Board-Folk/PC-Engine/(threads)

Thread 3 (2023-12-18):

There are spaces for components that aren’t on my PC Engine - can I leave them unpopulated?

PJSOConnell, 2023-12-18:
Hi there - L103 and L105 don’t exist on my PC Engine board revision.
As a result I have gaps on my reproduction board - should I populate it with something else?

SteveMaddison, 2024-01-13:
Sorry, missed this over the holidays but hopefully you figured it out. Those inductors don't look critical and just go to ground. I suspect on your donor board there is just a direct connection, in which case you can just bridge those footprints.
