Board-Folk/PC-Engine/connectors.kicad_sch

## KiCad design connectors.kicad_sch (2023-11-15)

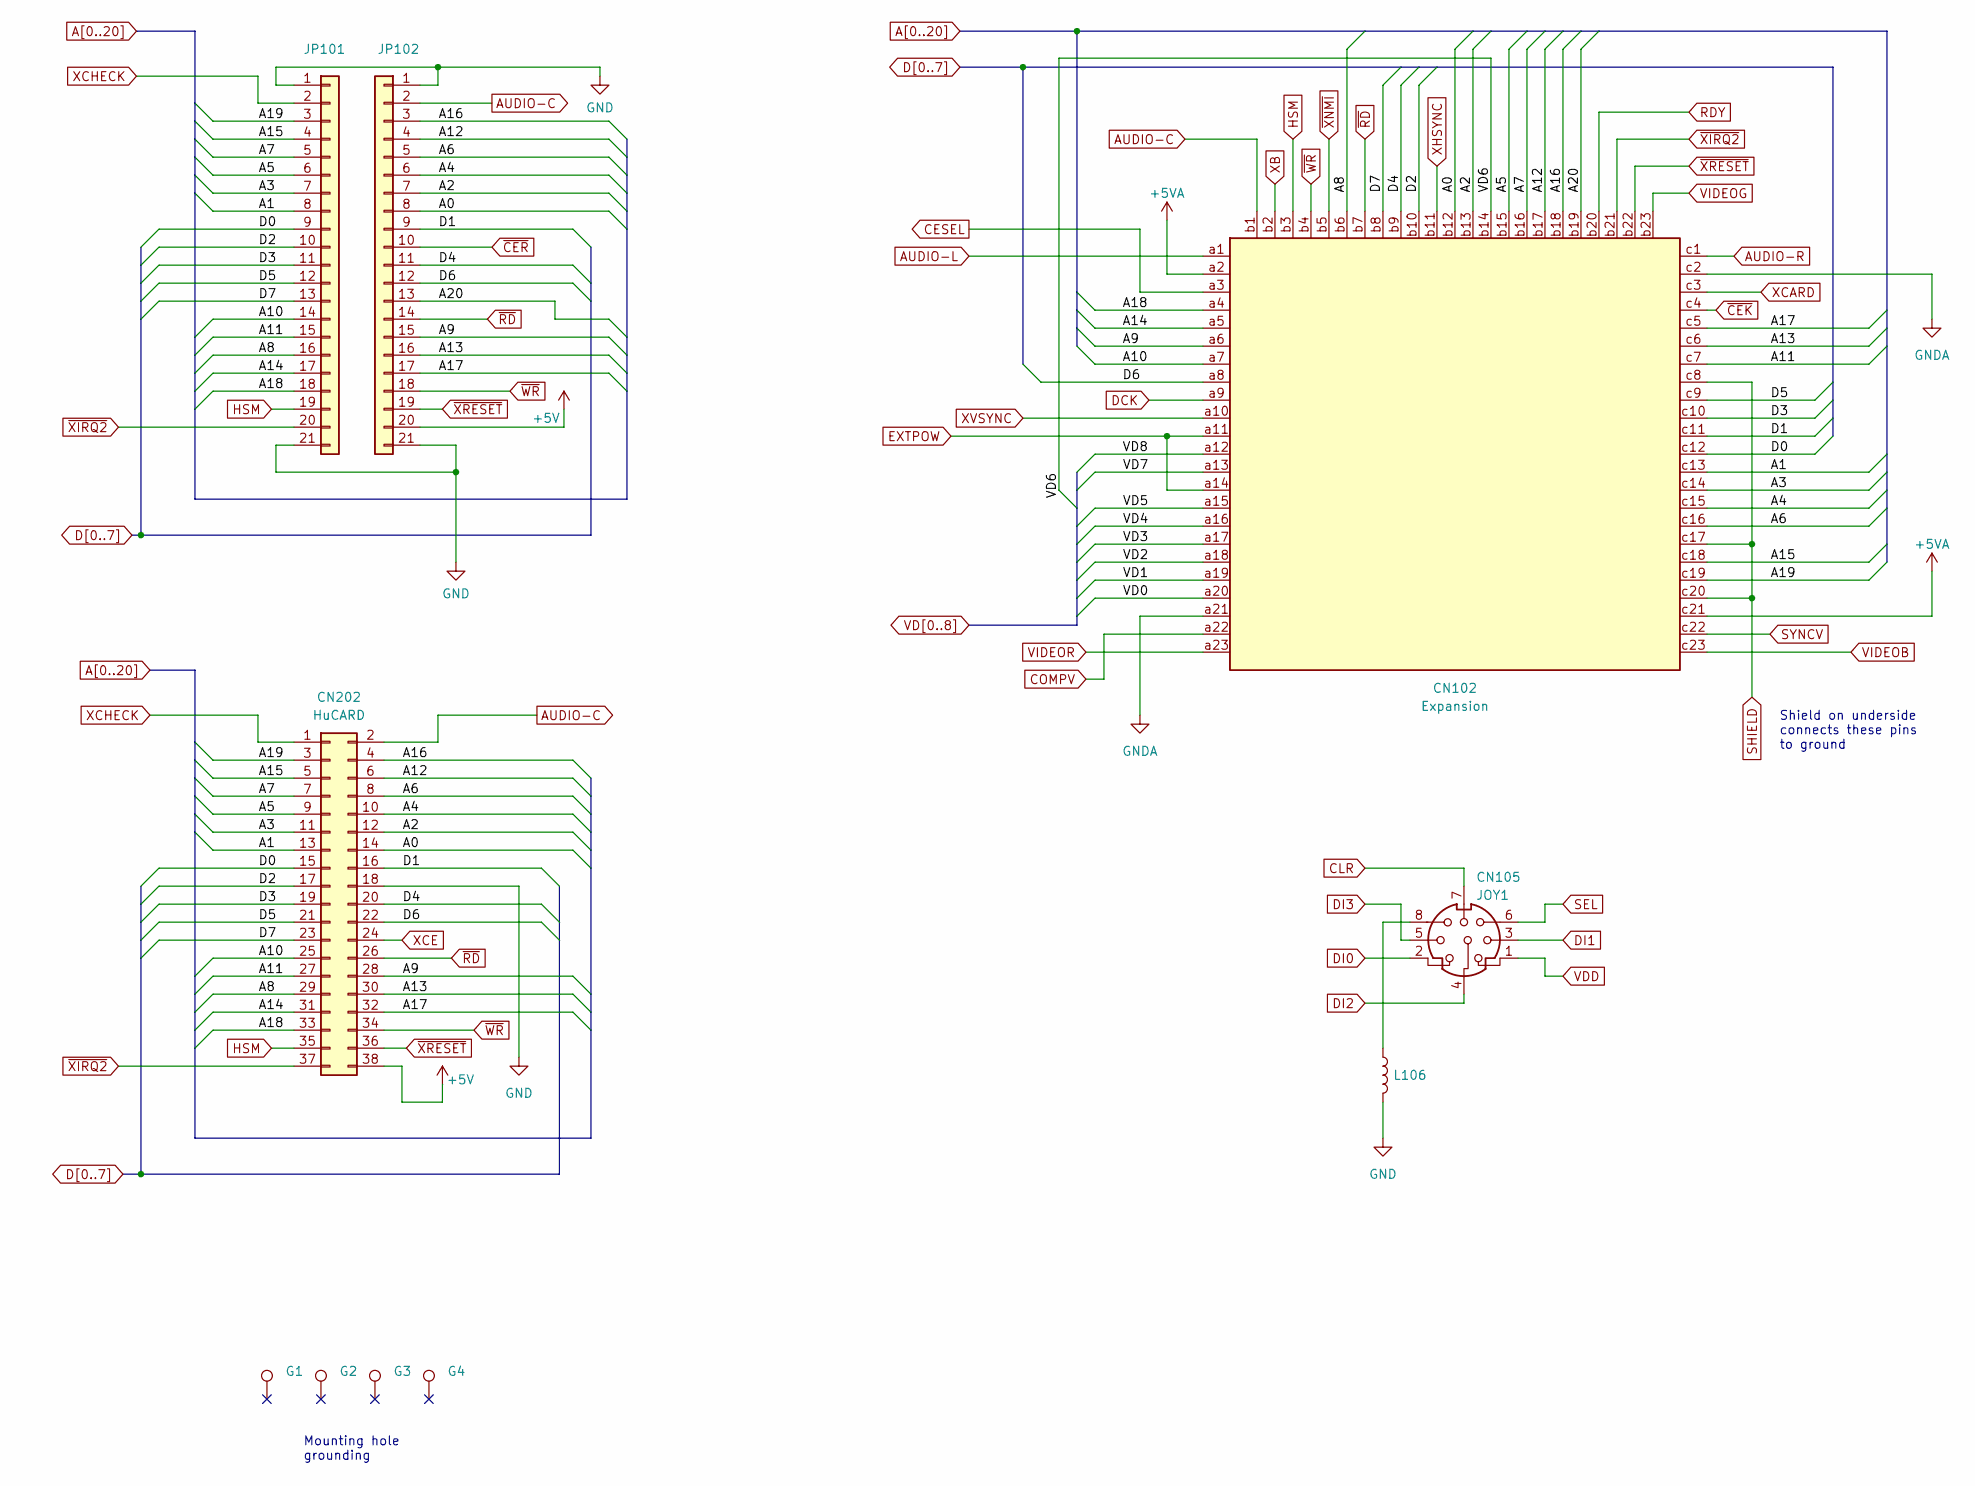
[picture p1: schematic connectors.kicad_sch]

Parts:
CN102: Expansion; CN102-2.54mm
CN105: JOY1; Mini-DIN-8
CN202: HuCARD
G1, G2, G3, G4: TestPoint; Grounding_pad
JP101, JP102: Conn_01x21; JP101-102-2.5mm
L106: L-5.00mm_Small_Silk

Connections:
+5V: CN202.38, JP102.20
+5VA: CN102.a2, CN102.c21
A0: CN102.b12, CN202.14, JP102.8
A1: CN102.c13, CN202.13, JP101.8
A2: CN102.b13, CN202.12, JP102.7
A3: CN102.c14, CN202.11, JP101.7
A4: CN102.c15, CN202.10, JP102.6
A5: CN102.b15, CN202.9, JP101.6
A6: CN102.c16, CN202.8, JP102.5
A7: CN102.b16, CN202.7, JP101.5
A8: CN102.b6, CN202.29, JP101.16
A9: CN102.a6, CN202.28, JP102.15
A10: CN102.a7, CN202.25, JP101.14
A11: CN102.c7, CN202.27, JP101.15
A12: CN102.b17, CN202.6, JP102.4
A13: CN102.c6, CN202.30, JP102.16
A14: CN102.a5, CN202.31, JP101.17
A15: CN102.c18, CN202.5, JP101.4
A16: CN102.b18, CN202.4, JP102.3
A17: CN102.c5, CN202.32, JP102.17
A18: CN102.a4, CN202.33, JP101.18
A19: CN102.c19, CN202.3, JP101.3
A20: CN102.b19, JP102.13
AUDIO-C: CN102.b1, CN202.2, JP102.2
AUDIO-L: CN102.a1
AUDIO-R: CN102.c1
CESEL: CN102.a3
CLR: CN105.7
COMPV: CN102.a22
D0: CN102.c12, CN202.15, JP101.9
D1: CN102.c11, CN202.16, JP102.9
D2: CN102.b10, CN202.17, JP101.10
D3: CN102.c10, CN202.19, JP101.11
D4: CN102.b9, CN202.20, JP102.11
D5: CN102.c9, CN202.21, JP101.12
D6: CN102.a8, CN202.22, JP102.12
D7: CN102.b8, CN202.23, JP101.13
DCK: CN102.a9
DI0: CN105.2
DI1: CN105.3
DI2: CN105.4
DI3: CN105.5
EXTPOW: CN102.a11, CN102.a14
GND: CN202.18, JP101.1, JP101.21, JP102.1, JP102.21, L106.2
GNDA: CN102.a21, CN102.c2
HSM: CN102.b3, CN202.35, JP101.19
unnamed: CN105.8, L106.1
RDY: CN102.b20
SEL: CN105.6
SHIELD: CN102.c8, CN102.c17, CN102.c20
SYNCV: CN102.c22
VD0: CN102.a20
VD1: CN102.a19
VD2: CN102.a18
VD3: CN102.a17
VD4: CN102.a16
VD5: CN102.a15
VD6: CN102.b14
VD7: CN102.a13
VD8: CN102.a12
VDD: CN105.1
VIDEOB: CN102.c23
VIDEOG: CN102.b23
VIDEOR: CN102.a23
XB: CN102.b2
XCARD: CN102.c3
XCE: CN202.24
XCHECK: CN202.1, JP101.2
XHSYNC: CN102.b11
XVSYNC: CN102.a10
~CEK: CN102.c4
~CER: JP102.10
~RD: CN102.b7, CN202.26, JP102.14
~WR: CN102.b4, CN202.34, JP102.18
~XIRQ2: CN102.b21, CN202.37, JP101.20
~XNMI: CN102.b5
~XRESET: CN102.b22, CN202.36, JP102.19

Notes on the sheet:
Shield on underside connects these pins to ground
Mounting hole grounding
