Board-Folk/PC-Engine/cpu.kicad_sch

## KiCad design cpu.kicad_sch (2023-11-15)

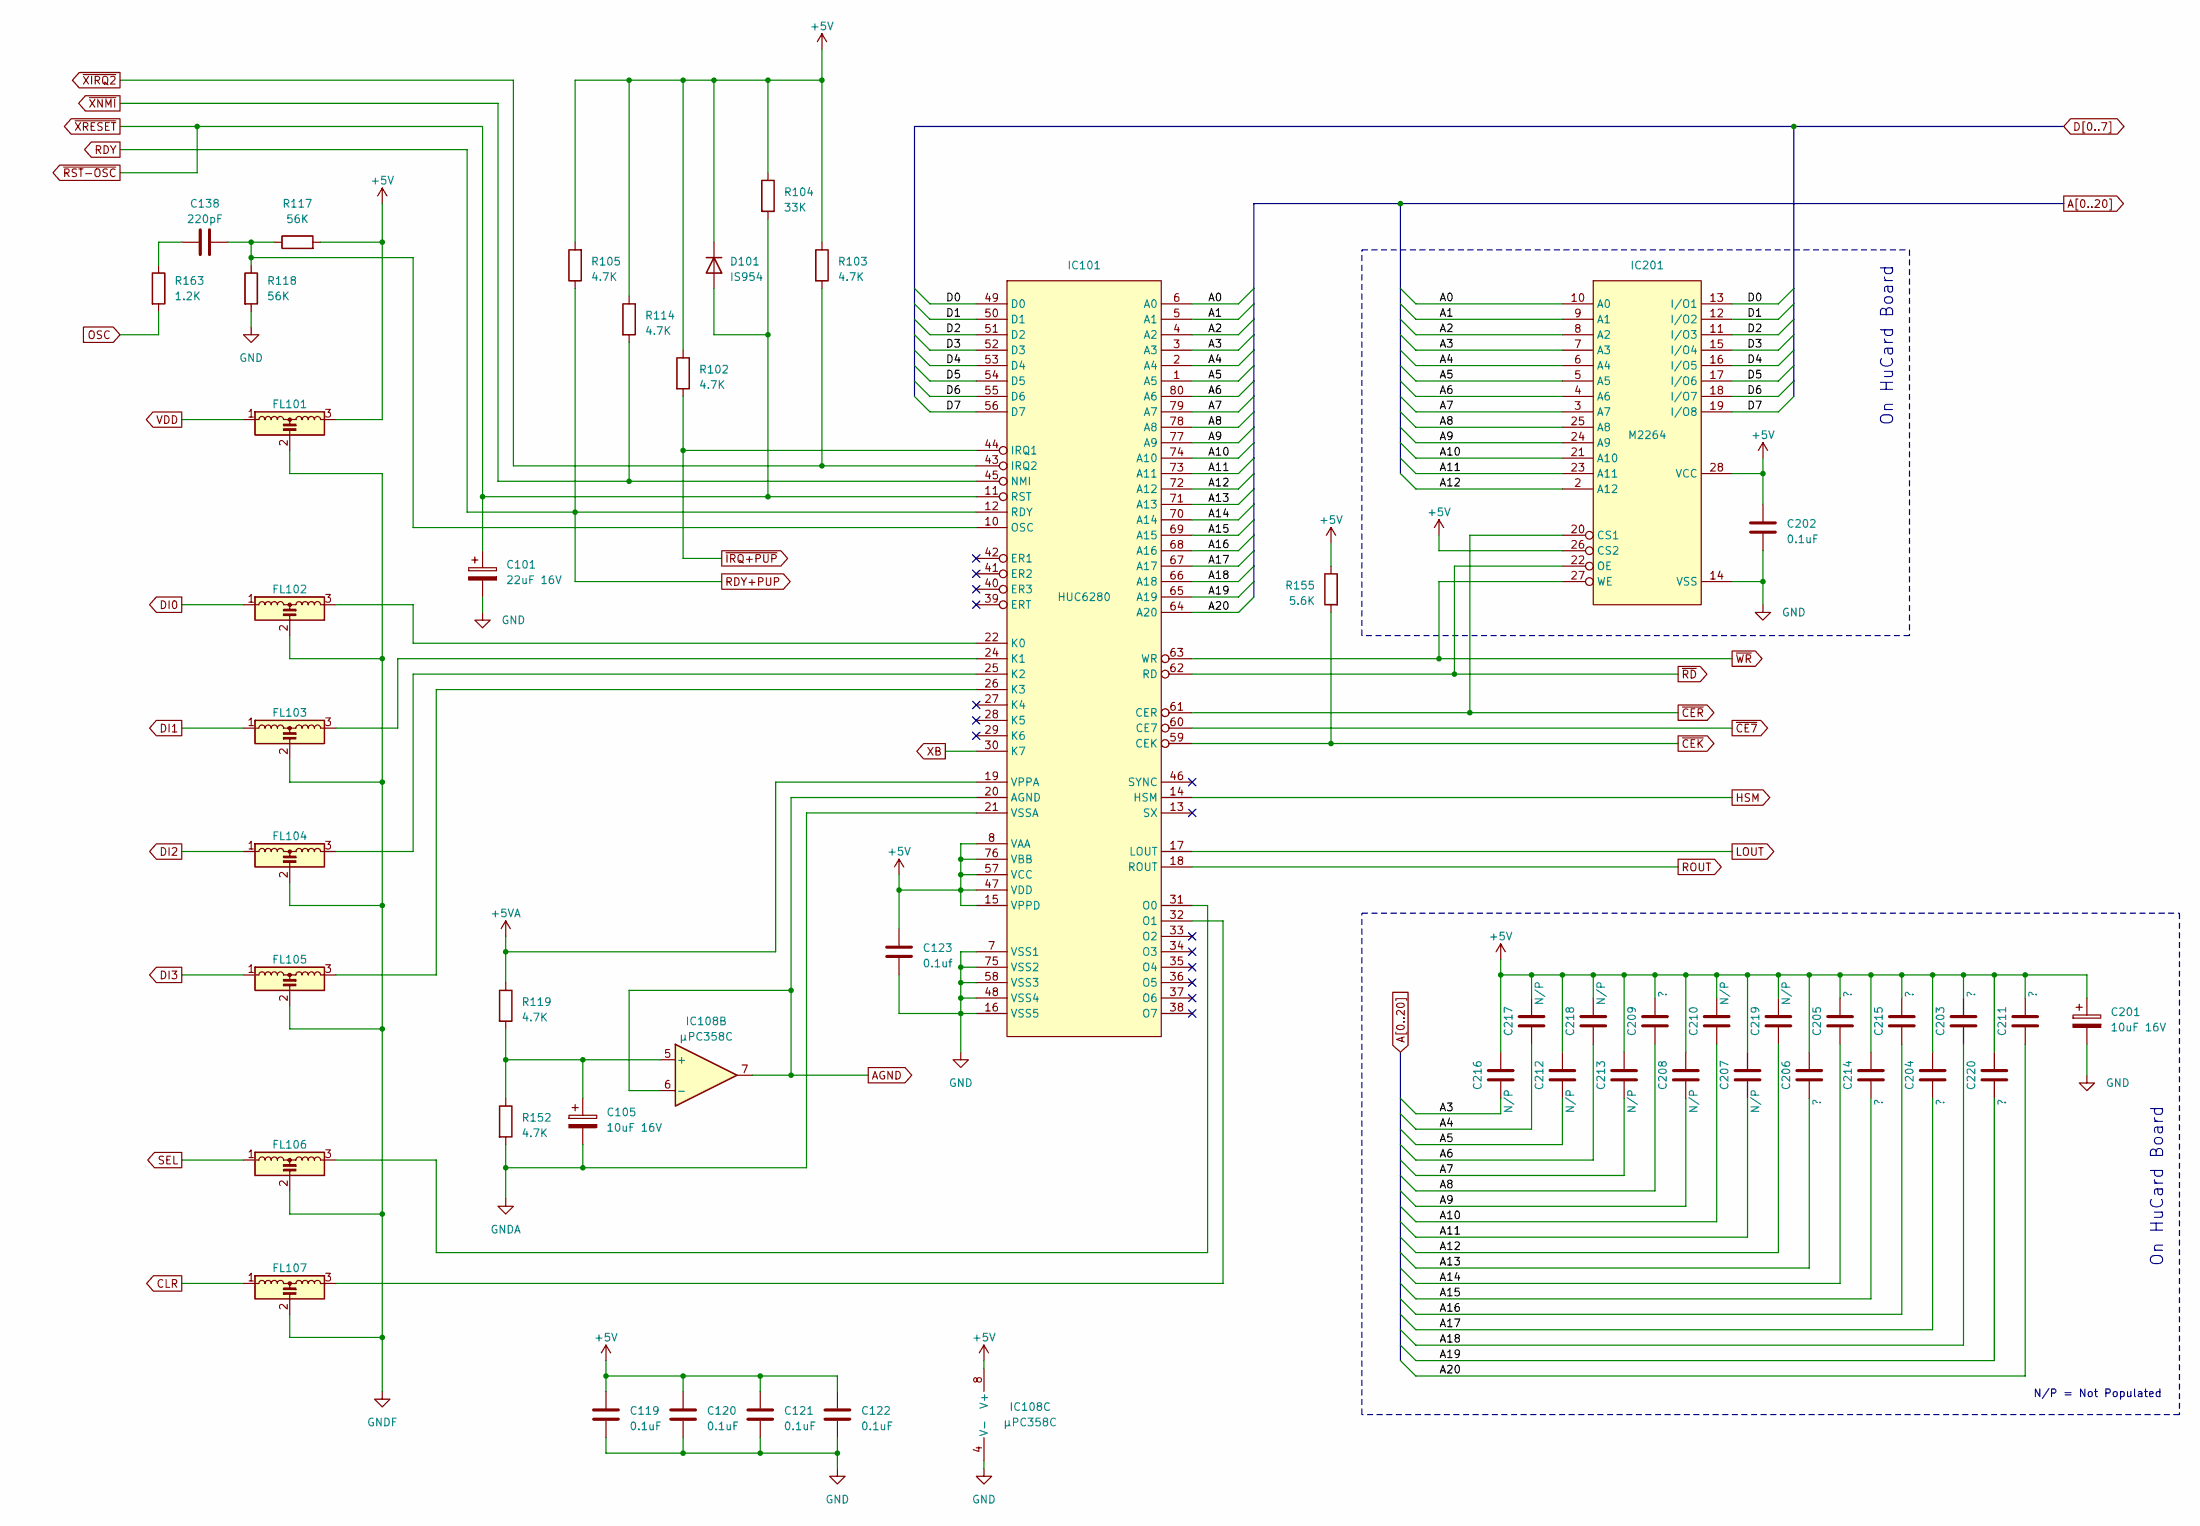
[picture p2: schematic cpu.kicad_sch]

Parts:
C101: 22uF 16V; Elec_P5.00mm
C105, C201: 10uF 16V; Elec_P5.00mm
C119, C120, C121, C122, C202: 0.1uF; SMD_1206_C
C123: 0.1uf; SMD_1206_C
C138: 220pF; SMD_1206
C203, C204, C205, C206, C209, C211, C214, C215, C220: ?; SMD_1206_C
C207, C208, C210, C212, C213, C216, C217, C218, C219: N/P; SMD_1206_C
D101: IS954; Diode_SMD
FL101, FL102, FL103, FL104, FL105, FL106, FL107: Filter_EMI_LCL; FL-5.00mm
IC101: HUC6280; HUC62xx
IC108: μPC358C; DIP-8
IC201: M2264
R102, R103, R105, R114, R119, R152: 4.7K; SMD_1206
R104: 33K; SMD_1206
R117, R118: 56K; SMD_1206
R155: 5.6K; SMD_1206
R163: 1.2K; SMD_1206

Connections:
+5V: C119.1, C120.1, C121.1, C122.1, C123.1, C201.1, C202.1, C203.1, C204.1, C205.1, C206.1, C207.1, C208.1, C209.1, C210.1, C211.1, C212.1, C213.1, C214.1, C215.1, C216.1, C217.1, C218.1, C219.1, C220.1, D101.1 (K), FL101.3, IC101.8 (VAA), IC101.15 (VPPD), IC101.47 (VDD), IC101.57 (VCC), IC101.76 (VBB), IC108.8 (V+), IC201.26 (CS2), IC201.28 (VCC), R102.1, R103.1, R104.1, R105.2, R114.1, R117.2, R155.1
+5VA: IC101.19 (VPPA), R119.1
A0: IC101.6 (A0), IC201.10 (A0)
A1: IC101.5 (A1), IC201.9 (A1)
A2: IC101.4 (A2), IC201.8 (A2)
A3: C216.2, IC101.3 (A3), IC201.7 (A3)
A4: C217.2, IC101.2 (A4), IC201.6 (A4)
A5: C212.2, IC101.1 (A5), IC201.5 (A5)
A6: C218.2, IC101.80 (A6), IC201.4 (A6)
A7: C213.2, IC101.79 (A7), IC201.3 (A7)
A8: C209.2, IC101.78 (A8), IC201.25 (A8)
A9: C208.2, IC101.77 (A9), IC201.24 (A9)
A10: C210.2, IC101.74 (A10), IC201.21 (A10)
A11: C207.2, IC101.73 (A11), IC201.23 (A11)
A12: C219.2, IC101.72 (A12), IC201.2 (A12)
A13: C206.2, IC101.71 (A13)
A14: C205.2, IC101.70 (A14)
A15: C214.2, IC101.69 (A15)
A16: C215.2, IC101.68 (A16)
A17: C204.2, IC101.67 (A17)
A18: C203.2, IC101.66 (A18)
A19: C220.2, IC101.65 (A19)
A20: C211.2, IC101.64 (A20)
AGND: IC101.20 (AGND), IC108.6 (-), IC108.7
CLR: FL107.1
D0: IC101.49 (D0), IC201.13 (I/O1)
D1: IC101.50 (D1), IC201.12 (I/O2)
D2: IC101.51 (D2), IC201.11 (I/O3)
D3: IC101.52 (D3), IC201.15 (I/O4)
D4: IC101.53 (D4), IC201.16 (I/O5)
D5: IC101.54 (D5), IC201.17 (I/O6)
D6: IC101.55 (D6), IC201.18 (I/O7)
D7: IC101.56 (D7), IC201.19 (I/O8)
DI0: FL102.1
DI1: FL103.1
DI2: FL104.1
DI3: FL105.1
GND: C101.2, C119.2, C120.2, C121.2, C122.2, C123.2, C201.2, C202.2, IC101.7 (VSS1), IC101.16 (VSS5), IC101.48 (VSS4), IC101.58 (VSS3), IC101.75 (VSS2), IC108.4 (V-), IC201.14 (VSS), R118.2
GNDA: C105.2, IC101.21 (VSSA), R152.2
GNDF: FL101.2, FL102.2, FL103.2, FL104.2, FL105.2, FL106.2, FL107.2
HSM: IC101.14 (HSM)
LOUT: IC101.17 (LOUT)
unnamed: C105.1, IC108.5 (+), R119.2, R152.1
unnamed: C138.1, R163.1
unnamed: C138.2, IC101.10 (OSC), R117.1, R118.1
unnamed: FL102.3, IC101.22 (K0)
unnamed: FL103.3, IC101.24 (K1)
unnamed: FL104.3, IC101.25 (K2)
unnamed: FL105.3, IC101.26 (K3)
unnamed: FL106.3, IC101.31 (O0)
unnamed: FL107.3, IC101.32 (O1)
OSC: R163.2
RDY: IC101.12 (RDY), R105.1
ROUT: IC101.18 (ROUT)
SEL: FL106.1
VDD: FL101.1
XB: IC101.30 (K7)
~CE7: IC101.60 (CE7)
~CEK: IC101.59 (CEK), R155.2
~CER: IC101.61 (CER), IC201.20 (CS1)
~IRQ+PUP: IC101.44 (IRQ1), R102.2
~RD: IC101.62 (RD), IC201.22 (OE)
~RST-OSC: C101.1, D101.2 (A), IC101.11 (RST), R104.2
~WR: IC101.63 (WR), IC201.27 (WE)
~XIRQ2: IC101.43 (IRQ2), R103.2
~XNMI: IC101.45 (NMI), R114.2

Notes on the sheet:
On HuCard Board
N/P = Not Populated
