Board-Folk/PC-Engine/power.kicad_sch

## KiCad design power.kicad_sch (2023-11-15)

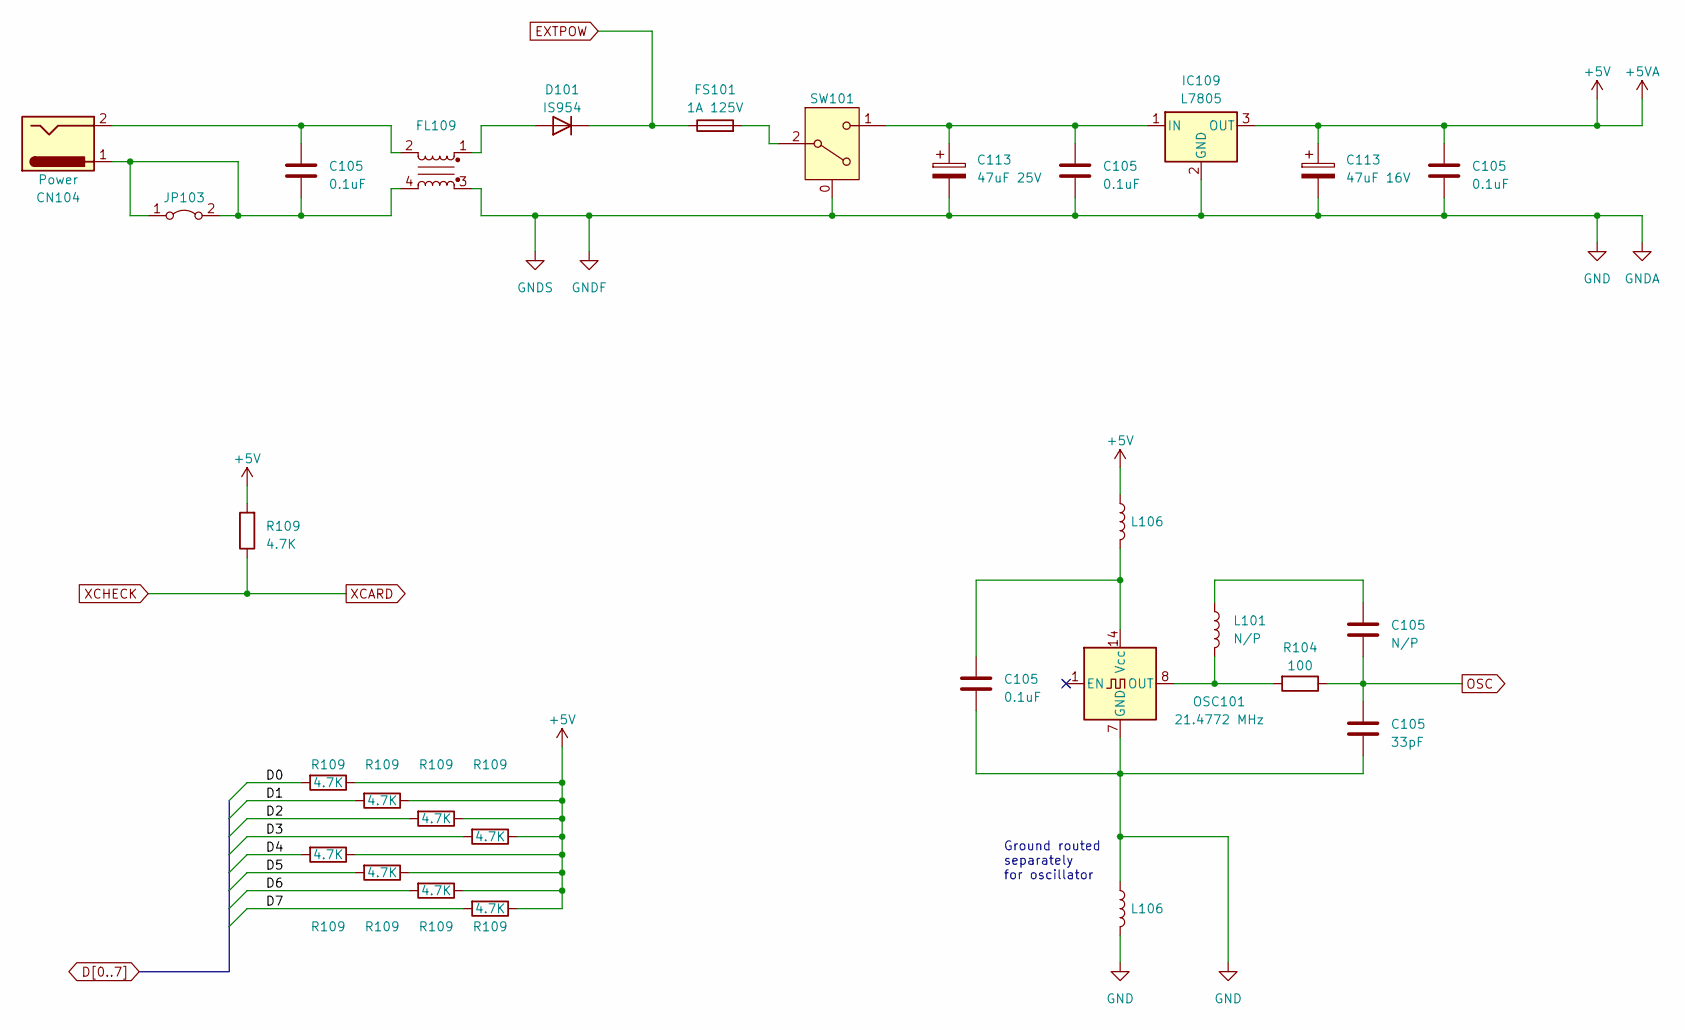
[picture p3: schematic power.kicad_sch]

Parts:
C105: 0.1uF; SMD_1206_C
C113: 47uF 25V; Elec_P5.00mm
CN104: Power; Barrel_Jack
D101: IS954; Diode
FL109: Filter_EMI_CommonMode; EMI_Dual_coil
FS101: 1A 125V; Fuse
IC109: L7805; IC109
JP103: 0; Jumper_Link
L101: N/P; 2xTest_Point
L106: L-5.00mm_Small_Silk
OSC101: 21.4772 MHz; Oscillator
R104: 100; SMD_1206
R109: 4.7K; SMD_1206
SW101: SW_SPDT; SW101

Connections:
+5V: C105.1, C113.1, IC109.3 (OUT), L106.1, R109.1, R109.2
D0: R109.2
D1: R109.2
D2: R109.2
D3: R109.2
D4: R109.2
D5: R109.2
D6: R109.2
D7: R109.2
EXTPOW: D101.1 (K), FS101.1
GND: C105.2, C113.2, FL109.3, IC109.2 (GND), L106.1, L106.2, OSC101.7 (GND), SW101.0 (CASE)
unnamed: C105.1, C113.1, CN104.2, FL109.2, IC109.1 (IN), L101.2, L106.2, OSC101.14 (Vcc), SW101.1 (A)
unnamed: C105.2, CN104.1, FL109.4, JP103.1 (A), JP103.2 (B)
unnamed: D101.2 (A), FL109.1
unnamed: FS101.2, SW101.2 (B)
unnamed: L101.1, OSC101.8 (OUT), R104.2
OSC: C105.1, C105.2, R104.1
XCARD: R109.1

Notes on the sheet:
Ground routed separately for oscillator
