Board-Folk/PC-Engine/vdc.kicad_sch

## KiCad design vdc.kicad_sch (2023-11-15)

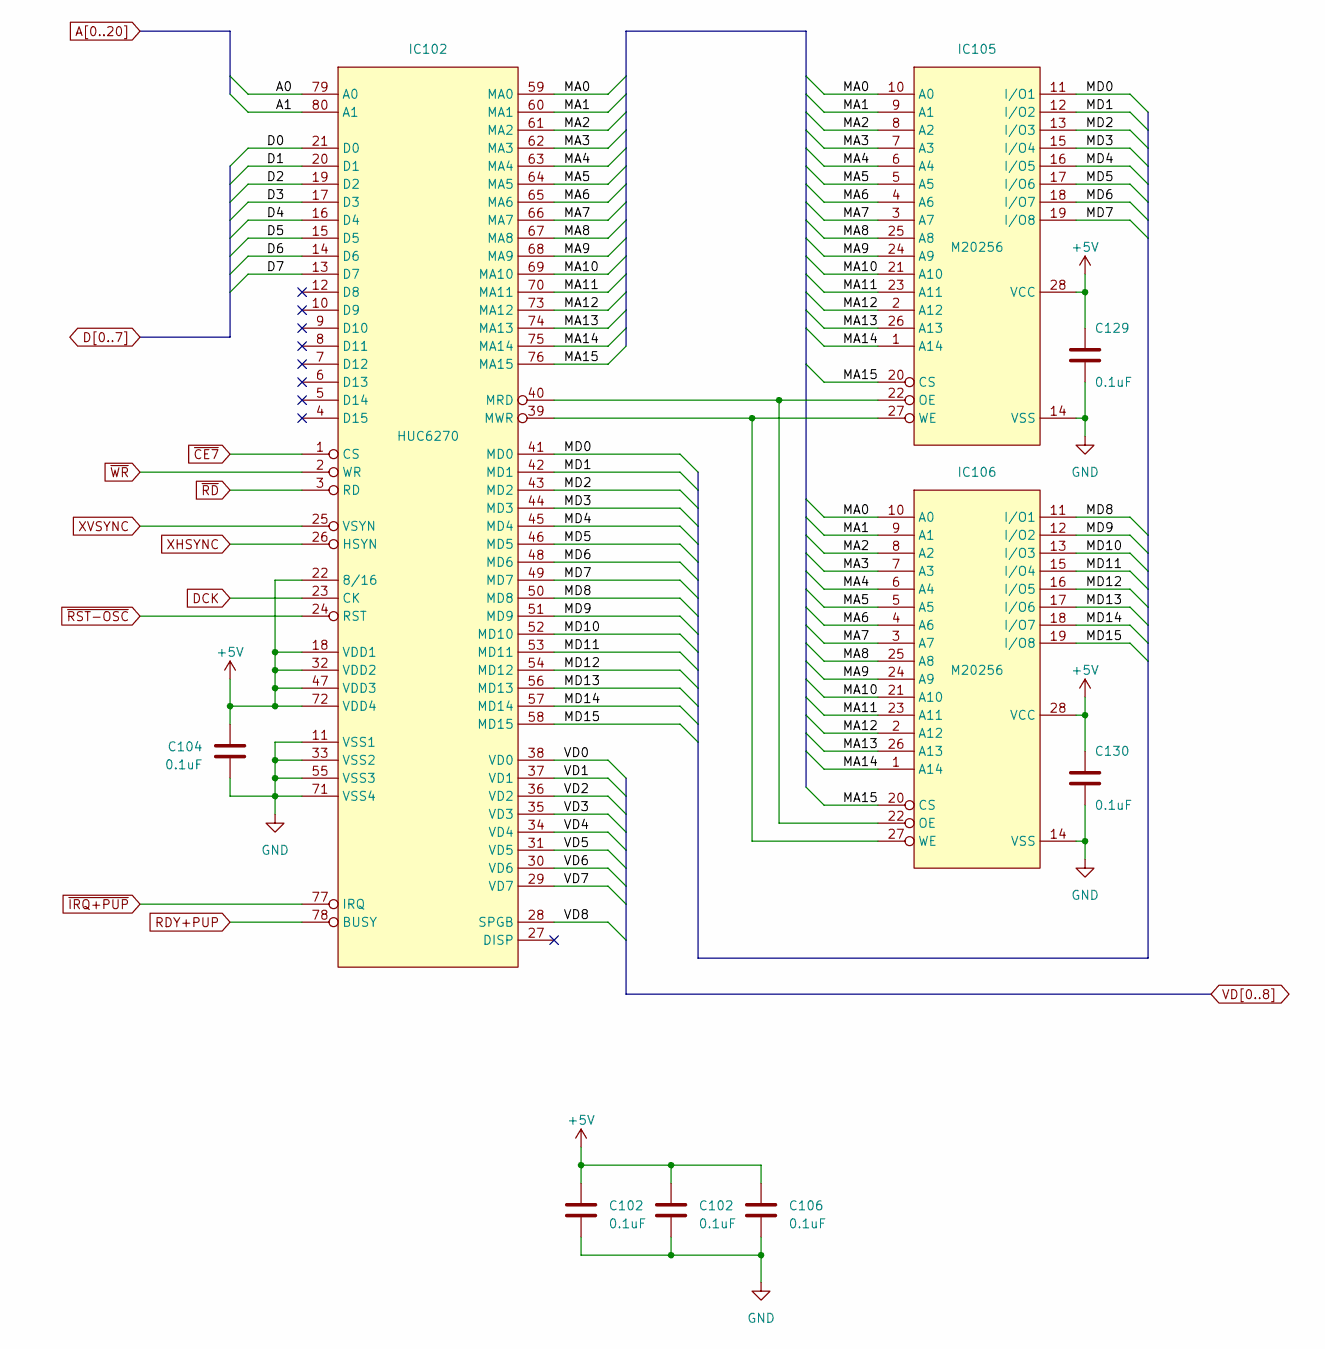
[picture p4: schematic vdc.kicad_sch]

Parts:
C102, C104, C106, C129, C130: 0.1uF; SMD_1206_C
IC102: HUC6270; HUC62xx
IC105, IC106: M20256; HSRM20256LM

Connections:
+5V: C102.1, C104.1, C106.1, C129.1, C130.1, IC102.18 (VDD1), IC102.22 (8/16), IC102.32 (VDD2), IC102.47 (VDD3), IC102.72 (VDD4), IC105.28 (VCC), IC106.28 (VCC)
A0: IC102.79 (A0)
A1: IC102.80 (A1)
D0: IC102.21 (D0)
D1: IC102.20 (D1)
D2: IC102.19 (D2)
D3: IC102.17 (D3)
D4: IC102.16 (D4)
D5: IC102.15 (D5)
D6: IC102.14 (D6)
D7: IC102.13 (D7)
DCK: IC102.23 (CK)
GND: C102.2, C104.2, C106.2, C129.2, C130.2, IC102.11 (VSS1), IC102.33 (VSS2), IC102.55 (VSS3), IC102.71 (VSS4), IC105.14 (VSS), IC106.14 (VSS)
MA0: IC102.59 (MA0), IC105.10 (A0), IC106.10 (A0)
MA1: IC102.60 (MA1), IC105.9 (A1), IC106.9 (A1)
MA2: IC102.61 (MA2), IC105.8 (A2), IC106.8 (A2)
MA3: IC102.62 (MA3), IC105.7 (A3), IC106.7 (A3)
MA4: IC102.63 (MA4), IC105.6 (A4), IC106.6 (A4)
MA5: IC102.64 (MA5), IC105.5 (A5), IC106.5 (A5)
MA6: IC102.65 (MA6), IC105.4 (A6), IC106.4 (A6)
MA7: IC102.66 (MA7), IC105.3 (A7), IC106.3 (A7)
MA8: IC102.67 (MA8), IC105.25 (A8), IC106.25 (A8)
MA9: IC102.68 (MA9), IC105.24 (A9), IC106.24 (A9)
MA10: IC102.69 (MA10), IC105.21 (A10), IC106.21 (A10)
MA11: IC102.70 (MA11), IC105.23 (A11), IC106.23 (A11)
MA12: IC102.73 (MA12), IC105.2 (A12), IC106.2 (A12)
MA13: IC102.74 (MA13), IC105.26 (A13), IC106.26 (A13)
MA14: IC102.75 (MA14), IC105.1 (A14), IC106.1 (A14)
MA15: IC102.76 (MA15), IC105.20 (CS), IC106.20 (CS)
MD0: IC102.41 (MD0), IC105.11 (I/O1)
MD1: IC102.42 (MD1), IC105.12 (I/O2)
MD2: IC102.43 (MD2), IC105.13 (I/O3)
MD3: IC102.44 (MD3), IC105.15 (I/O4)
MD4: IC102.45 (MD4), IC105.16 (I/O5)
MD5: IC102.46 (MD5), IC105.17 (I/O6)
MD6: IC102.48 (MD6), IC105.18 (I/O7)
MD7: IC102.49 (MD7), IC105.19 (I/O8)
MD8: IC102.50 (MD8), IC106.11 (I/O1)
MD9: IC102.51 (MD9), IC106.12 (I/O2)
MD10: IC102.52 (MD10), IC106.13 (I/O3)
MD11: IC102.53 (MD11), IC106.15 (I/O4)
MD12: IC102.54 (MD12), IC106.16 (I/O5)
MD13: IC102.56 (MD13), IC106.17 (I/O6)
MD14: IC102.57 (MD14), IC106.18 (I/O7)
MD15: IC102.58 (MD15), IC106.19 (I/O8)
unnamed: IC102.39 (MWR), IC105.27 (WE), IC106.27 (WE)
unnamed: IC102.40 (MRD), IC105.22 (OE), IC106.22 (OE)
RDY+PUP: IC102.78 (BUSY)
VD0: IC102.38 (VD0)
VD1: IC102.37 (VD1)
VD2: IC102.36 (VD2)
VD3: IC102.35 (VD3)
VD4: IC102.34 (VD4)
VD5: IC102.31 (VD5)
VD6: IC102.30 (VD6)
VD7: IC102.29 (VD7)
VD8: IC102.28 (SPGB)
XHSYNC: IC102.26 (HSYN)
XVSYNC: IC102.25 (VSYN)
~CE7: IC102.1 (CS)
~IRQ+PUP: IC102.77 (IRQ)
~RD: IC102.3 (RD)
~RST-OSC: IC102.24 (RST)
~WR: IC102.2 (WR)
