Board-Folk/PC-Engine/video.kicad_sch

## KiCad design video.kicad_sch (2023-11-15)

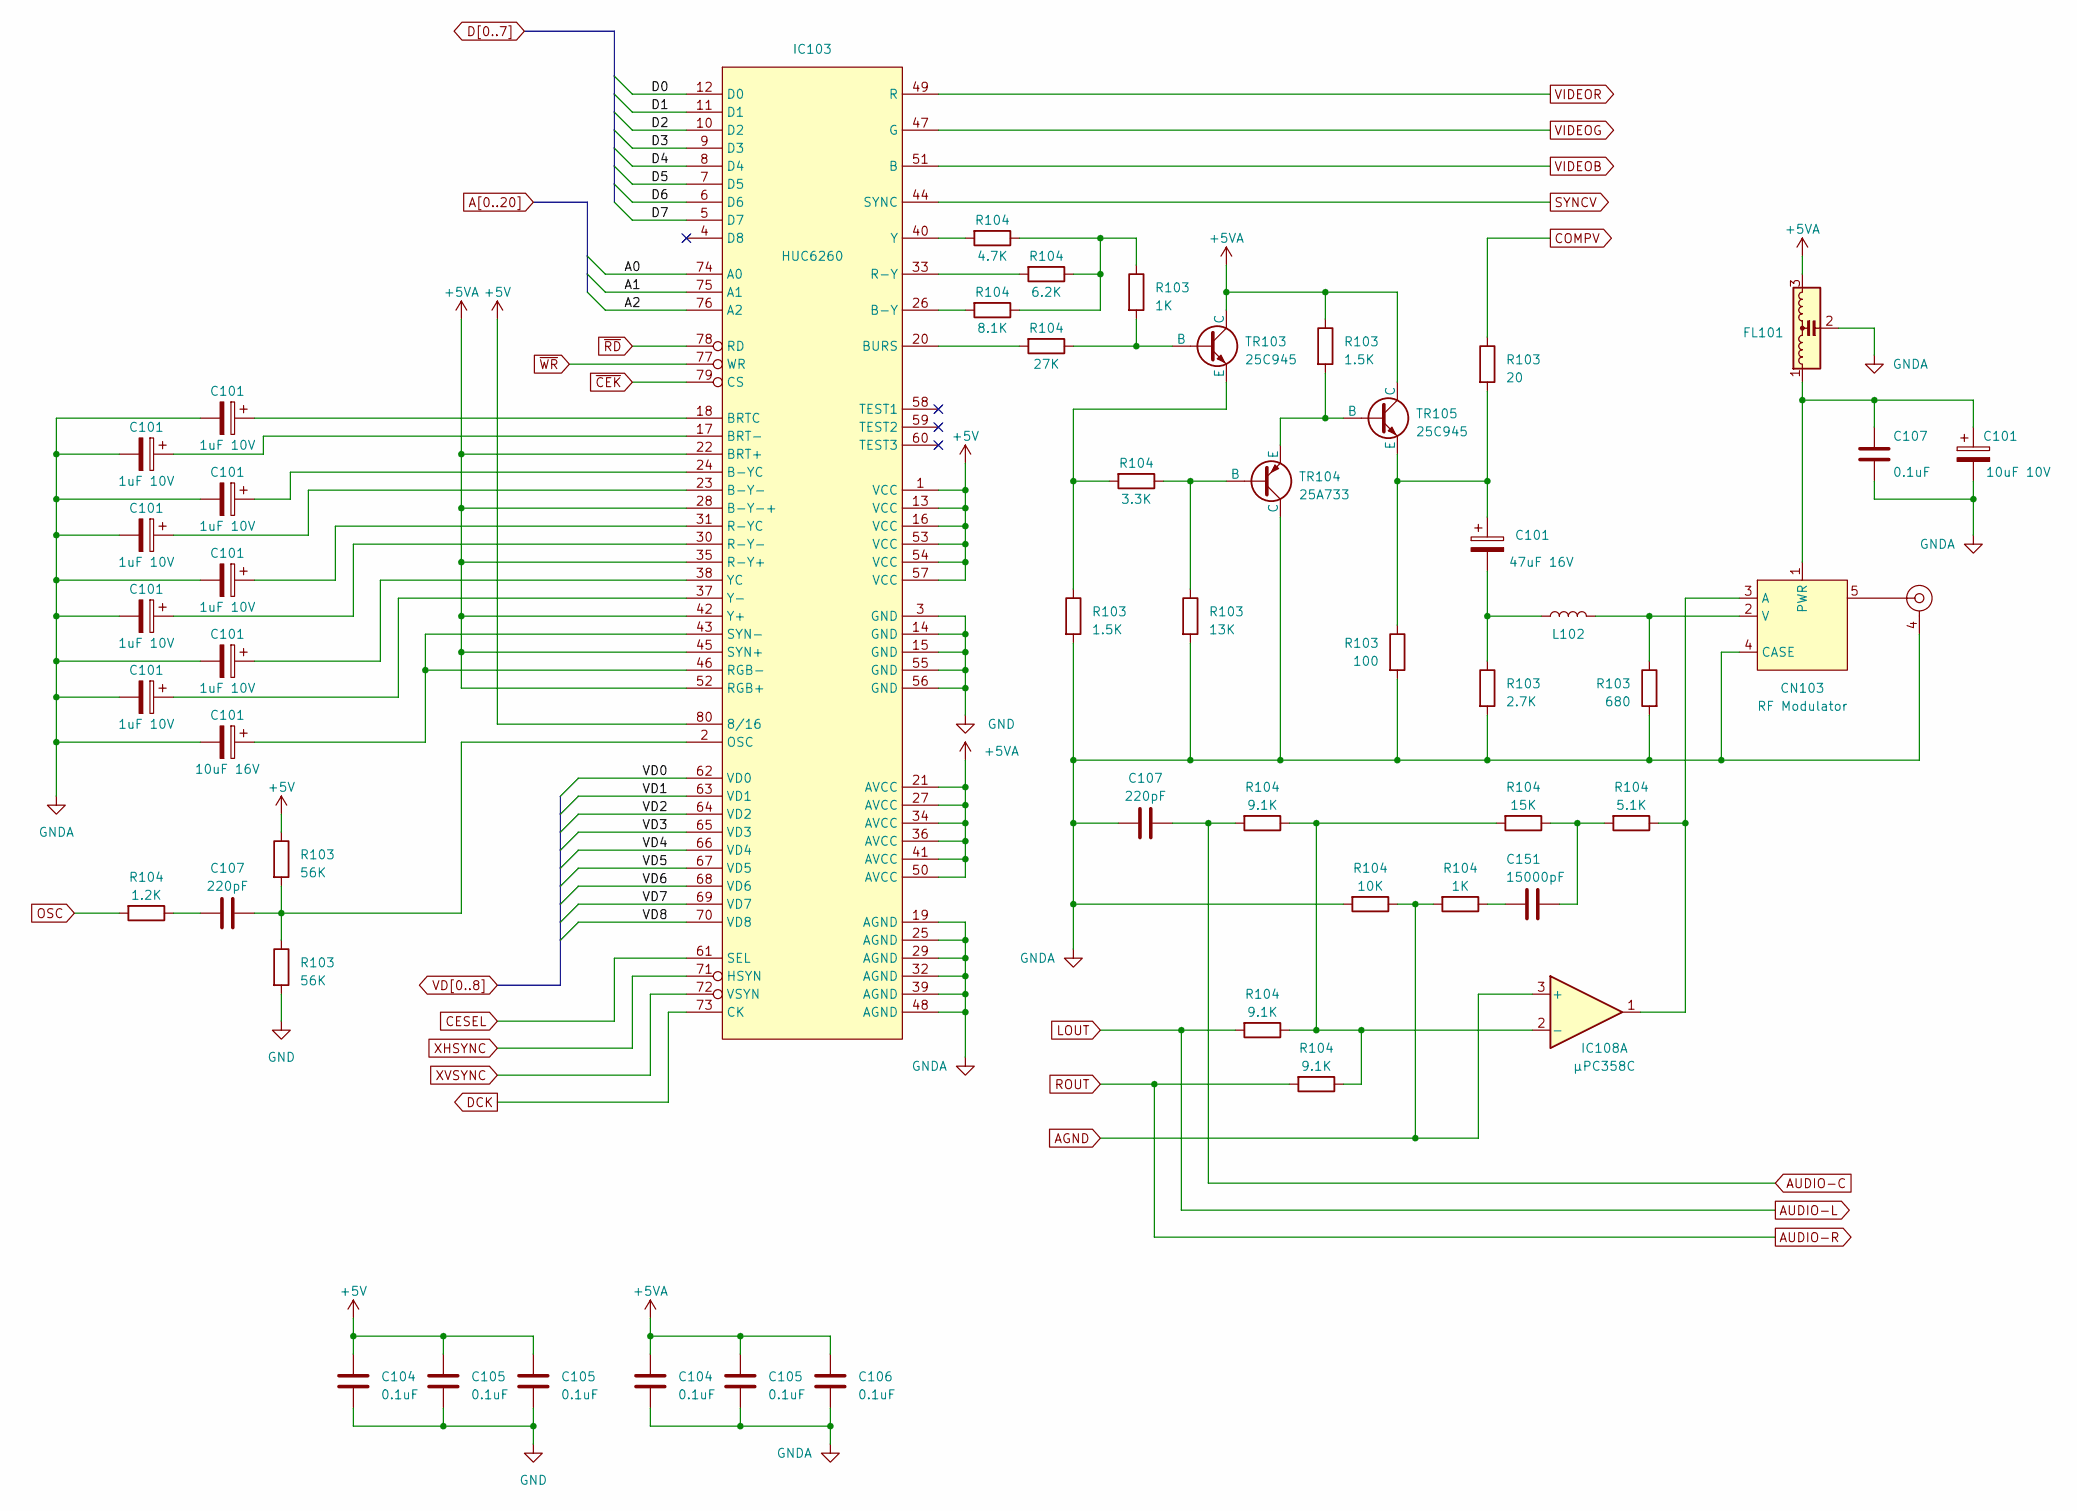
[picture p5: schematic video.kicad_sch]

Parts:
C101: 1uF 10V; Elec_P5.00mm
C104, C105, C106: 0.1uF; SMD_1206_C
C107: 220pF; SMD_1206
C151: 15000pF; SMD_1206_C
CN103: RF Modulator; CN103
FL101: Filter_EMI_LCL; FL-5.00mm
IC103: HUC6260; HUC62xx
IC108: μPC358C; DIP-8
L102: L-5.00mm
R103: 56K; SMD_1206
R104: 4.7K; SMD_1206
TR103, TR105: 25C945; Transistor_SMD
TR104: 25A733; Transistor_SMD

Connections:
+5V: C104.1, C105.1, IC103.1 (VCC), IC103.13 (VCC), IC103.16 (VCC), IC103.53 (VCC), IC103.54 (VCC), IC103.57 (VCC), IC103.80 (8/16), R103.1
+5VA: C104.1, C105.1, C106.1, FL101.3, IC103.21 (AVCC), IC103.22 (BRT+), IC103.27 (AVCC), IC103.28 (B-Y-+), IC103.34 (AVCC), IC103.35 (R-Y+), IC103.36 (AVCC), IC103.41 (AVCC), IC103.42 (Y+), IC103.45 (SYN+), IC103.50 (AVCC), IC103.52 (RGB+), R103.1, TR103.1 (C), TR105.1 (C)
A0: IC103.74 (A0)
A1: IC103.75 (A1)
A2: IC103.76 (A2)
AGND: IC108.3 (+), R104.1, R104.2
AUDIO-C: C107.2, R104.2
AUDIO-L: R104.2
AUDIO-R: R104.2
CESEL: IC103.61 (SEL)
COMPV: R103.1
D0: IC103.12 (D0)
D1: IC103.11 (D1)
D2: IC103.10 (D2)
D3: IC103.9 (D3)
D4: IC103.8 (D4)
D5: IC103.7 (D5)
D6: IC103.6 (D6)
D7: IC103.5 (D7)
DCK: IC103.73 (CK)
GND: C104.2, C105.2, IC103.3 (GND), IC103.14 (GND), IC103.15 (GND), IC103.55 (GND), IC103.56 (GND), R103.2
GNDA: C101.2, C104.2, C105.2, C106.2, C107.1, CN103.4, FL101.2, IC103.19 (AGND), IC103.25 (AGND), IC103.29 (AGND), IC103.32 (AGND), IC103.39 (AGND), IC103.48 (AGND), R103.2, R104.2, TR104.1 (C)
unnamed: C101.1, C107.2, CN103.1 (PWR), FL101.1, IC103.17 (BRT-), IC103.18 (BRTC), IC103.23 (B-Y-), IC103.24 (B-YC), IC103.30 (R-Y-), IC103.31 (R-YC), IC103.37 (Y-), IC103.38 (YC), IC103.43 (SYN-), IC103.46 (RGB-), R103.1, R103.2, TR105.3 (E)
unnamed: C101.2, L102.1, R103.1
unnamed: C107.1, R104.1
unnamed: C107.2, IC103.2 (OSC), R103.1, R103.2
unnamed: C151.1, R104.1, R104.2
unnamed: C151.2, R104.1
unnamed: CN103.2 (V), L102.2, R103.1
unnamed: CN103.3 (A), IC108.1, R104.1
unnamed: IC103.20 (BURS), R104.2
unnamed: IC103.26 (B-Y), R104.2
unnamed: IC103.33 (R-Y), R104.2
unnamed: IC103.40 (Y), R104.2
unnamed: IC108.2 (-), R104.1, R104.2
unnamed: R103.1, R104.1, R104.2, TR103.3 (E), TR104.2 (B)
unnamed: R103.2, R104.1, TR103.2 (B), TR104.3 (E), TR105.2 (B)
OSC: R104.2
SYNCV: IC103.44 (SYNC)
VD0: IC103.62 (VD0)
VD1: IC103.63 (VD1)
VD2: IC103.64 (VD2)
VD3: IC103.65 (VD3)
VD4: IC103.66 (VD4)
VD5: IC103.67 (VD5)
VD6: IC103.68 (VD6)
VD7: IC103.69 (VD7)
VD8: IC103.70 (VD8)
VIDEOB: IC103.51 (B)
VIDEOG: IC103.47 (G)
VIDEOR: IC103.49 (R)
XHSYNC: IC103.71 (HSYN)
XVSYNC: IC103.72 (VSYN)
~CEK: IC103.79 (CS)
~RD: IC103.78 (RD)
~WR: IC103.77 (WR)
