Board-Folk/PC-Engine/(commit log)

2023-08-18 Finish layout based on schematics adapted from TurboGrafx-16 (#1)
    [PCE-B_Cu.gbl, PCE-B_Mask.gbs, PCE-B_Paste.gbp, PCE-B_Silkscreen.gbo, PCE-Edge_Cuts.gm1, PCE-F_Cu.gtl, PCE-F_Mask.gts, PCE-F_Paste.gtp]
2023-08-25 Update README, removed minor kinks from some traces.
    [video.kicad_sch]
2023-08-25 Update gerbers to match PCB.
    [PCE-B_Cu.gbl, PCE-B_Mask.gbs, PCE-B_Paste.gbp, PCE-B_Silkscreen.gbo, PCE-Edge_Cuts.gm1, PCE-F_Cu.gtl, PCE-F_Mask.gts, PCE-F_Paste.gtp]
2023-08-28 Remove some sharp corners on traces, generate BOM.
    [connectors.kicad_sch, power.kicad_sch, video.kicad_sch]
2023-08-28 Link to interactive BOM from README.
2023-08-28 Link to interactive BOM from README. (2)
2023-08-28 Link to interactive BOM from README. (3)
2023-08-28 Remove more sharp corners form traces.
2023-08-28 Add recommended PCB finish to README.
2023-08-28 Add recommended PCB finish to README. (2)
2023-09-18 Prepare release.
    [PCE-B_Cu.gbl, PCE-B_Mask.gbs, PCE-B_Paste.gbp, PCE-B_Silkscreen.gbo, PCE-Edge_Cuts.gm1, PCE-F_Cu.gtl, PCE-F_Mask.gts, PCE-F_Paste.gtp]
2023-09-19 Widen hole for shield tab near voltage regulator.
2023-09-20 Inductor symbol for L101, schematic layout clean-up.
    [PCE.kicad_sch, connectors.kicad_sch, cpu.kicad_sch, power.kicad_sch, vdc.kicad_sch, video.kicad_sch]
2023-09-20 Dedicated directory for JLC gerbers.
    [PCE-B_Cu.gbl, PCE-B_Mask.gbs, PCE-B_Paste.gbp, PCE-B_Silkscreen.gbo, PCE-Edge_Cuts.gm1, PCE-F_Cu.gtl, PCE-F_Mask.gts, PCE-F_Paste.gtp]
2023-09-20 Generate separate Gerbers for JLC and PCBWay.
    [PCE-B_Cu.gbl, PCE-B_Mask.gbs, PCE-B_Paste.gbp, PCE-B_Silkscreen.gbo, PCE-Edge_Cuts.gm1, PCE-F_Cu.gtl, PCE-F_Mask.gts, PCE-F_Paste.gtp]
2023-09-21 Add top layer copper to barrel jack footprint to ensure hole is plated by default.
2023-09-21 Add PCB fabrication and revision information to README.
2023-10-04 Cosmetic trace/silkscreen changes.
2023-11-15 Add contact info the schematics for publishing.
    [PCE.kicad_sch, connectors.kicad_sch, cpu.kicad_sch, power.kicad_sch, vdc.kicad_sch, video.kicad_sch]
